sixfab/tinylab/README.md

# tinylab
[tinylab](https://sixfab.com/product/tinylab-exclusive-kit/) : prototype easier than ever
