sixfab/tinylab/case/tinylab_cap.STL

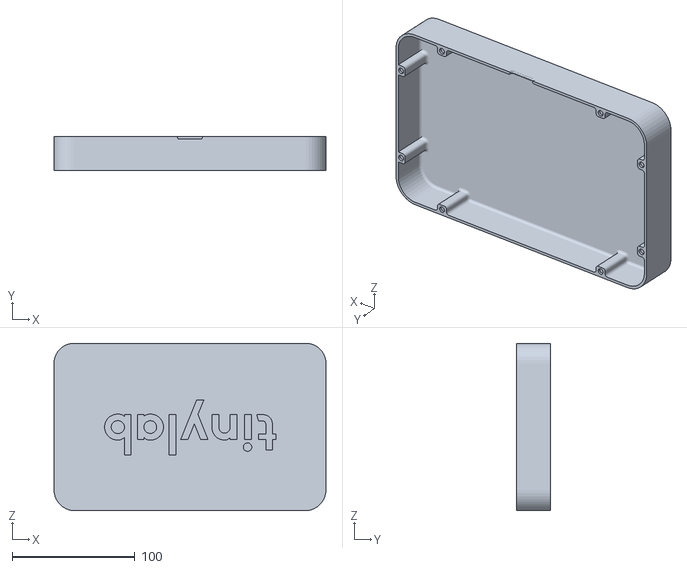
[picture p1: CAD file, 2016-04-21]
case/tinylab_cap.STL
221.3 x 27.5 x 136.2
