sixfab/tinylab/case/tinylab_bottom_plate.STL

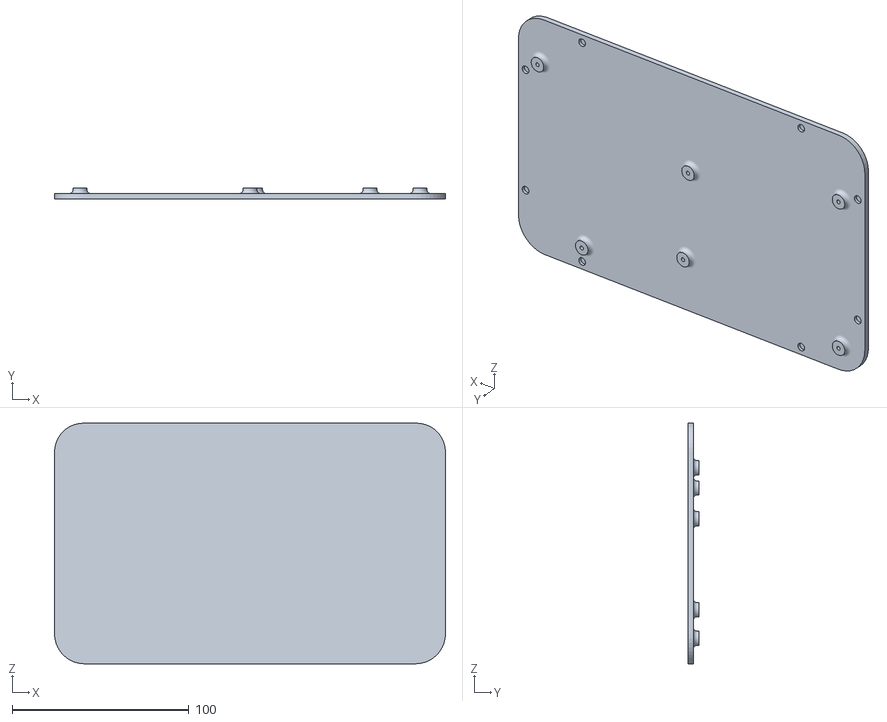
[picture p2: CAD file, 2016-04-21]
case/tinylab_bottom_plate.STL
221.3 x 6.00 x 136.2
