sixfab/tinylab/hardware/tinylab_09-03-16.brd

## EAGLE design hardware/tinylab_09-03-16.brd (2016-04-22)

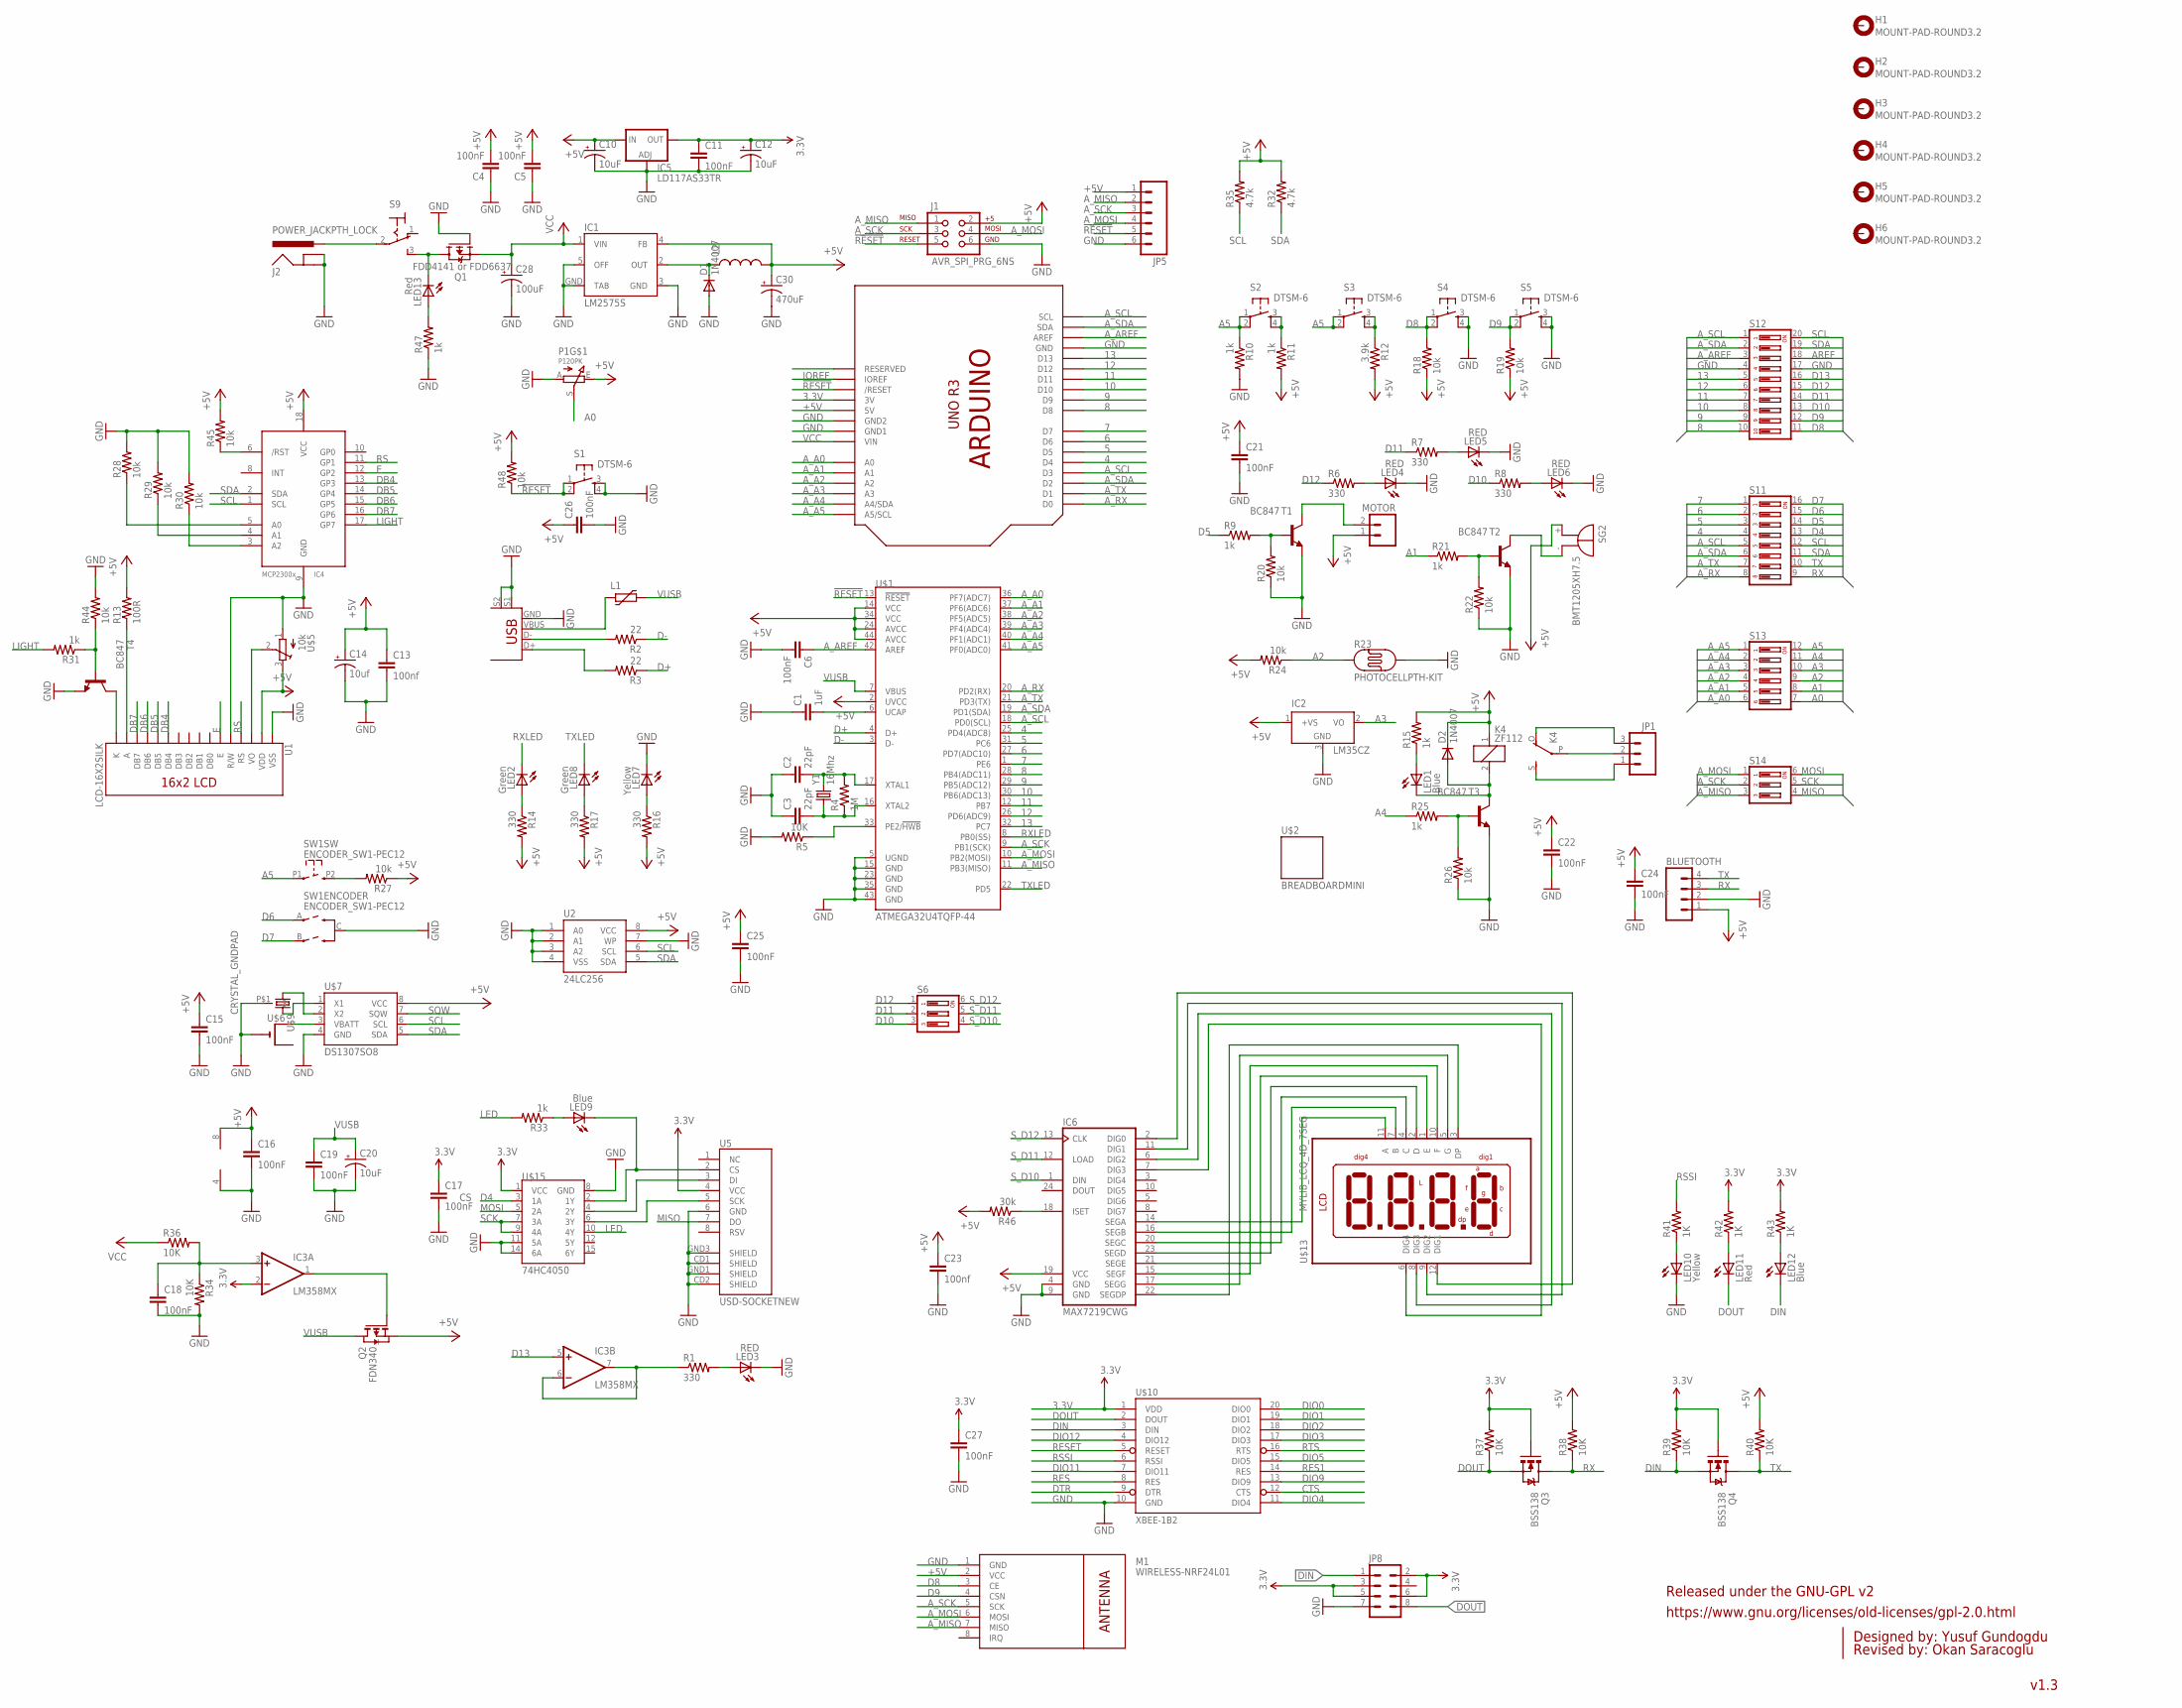
[picture p3: schematic tinylab_09-03-16.sch]

Parts:
BLUETOOTH: M04PTH; 1X04
C1: 1uF; 1206
C2, C3: 22pF; 0805
C4, C5, C6, C11, C15, C16, C17, C18, C19, C21, C22, C24, C25, C26, C27: 100nF; 0805
C10, C12, C20: 10uF; EIA3216
C13, C23: 100nf; 0805
C14: 10uf; EIA3216
C28: 100uF; NIPPON_F80
C30: 470uF; PANASONIC_G
D1, D2: 1N4007; SMA-DIODE_ALT
H1, H2, H3, H4, H5, H6: MOUNT-PAD-ROUND3.2; 3,2-PAD
IC1: LM2575S; TO263-5
IC2: LM35CZ; TO92
IC3: LM358MX; SO08
IC4: MCP2300X/SO; SO18W
IC5: LD117AS33TR; SOT223
IC6: MAX7219CWG; SO24W
J1: AVR_SPI_PRG_6NS; 2X3-NS
J2: POWER_JACKPTH_LOCK; POWER_JACK_PTH_LOCK
JP1: M03-SCREW-5MM; SCREWTERMINAL-5MM-3
JP5: M06SIP; 1X06
JP8: M04X2; 2X4
K4: ZF112
L1: FUSE_PTC-0805; PTC0805
L2: INDUCTORPWR; CDRH125
LED1, LED9, LED12: Blue; CHIPLED_0805
LED2, LED8: Green; CHIPLED_0805
LED3, LED4, LED5, LED6: RED; LED5MM
LED7, LED10: Yellow; CHIPLED_0805
LED11, LED13: Red; CHIPLED_0805
M1: WIRELESS-NRF24L01
MOTOR: M023.5MM; SCREWTERMINAL-3.5MM-2
P1: P120PK
Q1: FDD4141 or FDD6637; TO252
Q2: FDN340; SOT-23
Q3, Q4: BSS138; SOT23-3
R1, R6, R7, R8, R14, R16, R17: 330; 0805
R2, R3: 22; 0805
R4: 1M; 0805
R5, R34, R36, R37, R38, R39, R40: 10K; 0805
R9, R10, R11, R15, R21, R25, R31, R33, R47: 1k; 0805
R12: 3.9k; 0805
R13: 100R; 0805
R18, R19, R20, R22, R24, R26, R27, R28, R29, R30, R44, R45, R48: 10k; 0805
R23: PHOTOCELLPTH-KIT; PHOTOCELL-KIT
R32, R35: 4.7k; 0805
R41, R42, R43: 1K; 0805
R46: 30k; 0805
S1, S2, S3, S4, S5: DTSM-6
S6, S14: DIP03YL
S9: M9040P
S11: DIP08YL
S12: DIP10YL
S13: DIP06YL
SG2: BMT1205XH7.5
SW1: ENCODER_SW1-PEC12; PEC12_INCREMENTAL_ENCODER
T1, T2, T3, T4: BC847; SOT23-BEC
U1: LCD-16X2SILK; LCD-16X2
U2: 24LC256; SO08
U5: USD-SOCKETNEW; MICRO-SD-SOCKET-PP
U$1: ATMEGA32U4TQFP-44; TQFP44
U$2: BREADBOARDMINI; BREADBOARD-MINI
U$3: USB+SHIELD; USB-B-PTH
U$4: UNO_R3
U$5: 10k; TC33X
U$6: CR1220SMT; CR1220-SMD
U$7: DS1307SO8; SO08
U$9: CRYSTAL_GNDPAD; TC38H_GNDPAD
U$10: XBEE-1B2; XBEE-SILK
U$13: MYLIB_LCQ_4D_7SEG; MYLIB_LDQ_4D_7SEG
U$15: 74HC4050; SO016
Y1: 16Mhz; CRYSTAL-SMD-5X3

Connections:
3.3V: C11.1, C12.A (+), C17.1, C27.1, IC3.2 (-IN), IC5.4 (OUT), JP8.2, JP8.3, JP8.5, JP8.6, Q3.1 (G), Q4.1 (G), R37.2, R39.2, R42.2, R43.2, U5.4 (VCC), U$4.3V, U$10.1 (VDD), U$15.1 (VCC)
4: S11.4, U$1.25 (PD4(ADC8)), U$4.D4
5: S11.3, U$1.31 (PC6), U$4.D5
6: S11.2, U$1.27 (PD7(ADC10)), U$4.D6
7: S11.1, U$1.1 (PE6), U$4.D7
8: S12.10, U$1.28 (PB4(ADC11)), U$4.D8
9: S12.9, U$1.29 (PB5(ADC12)), U$4.D9
10: S12.8, U$1.30 (PB6(ADC13)), U$4.D10
11: S12.7, U$1.12 (PB7), U$4.D11
12: S12.6, U$1.26 (PD6(ADC9)), U$4.D12
13: S12.5, U$1.32 (PC7), U$4.D13
!RESET: J1.5, JP5.5, R48.1, S1.1, S1.2, U$1.13 (!RESET), U$4.RESET (/RESET)
+5V: BLUETOOTH.1, C4.2, C5.2, C10.A (+), C13.1, C14.A (+), C15.1, C16.1, C21.1, C22.1, C23.1, C24.1, C25.1, C26.1, C30.+, D2.C, IC1.4 (FB), IC2.1 (+VS), IC3.8 (V+), IC4.18 (VCC), IC5.3 (IN), IC6.19 (VCC), J1.2, JP5.1, K4.1, L2.2, M1.2 (VCC), MOTOR.1, P1.E, Q2.2 (S), R11.2, R12.2, R13.2, R14.2, R15.2, R16.2, R17.2, R18.1, R19.1, R24.2, R27.1, R32.2, R35.2, R38.2, R40.2, R45.2, R46.2, R48.2, SG2.+, U1.2 (VDD), U2.8 (VCC), U$1.2 (UVCC), U$1.14 (VCC), U$1.24 (AVCC), U$1.34 (VCC), U$1.44 (AVCC), U$4.5V, U$5.3 (E), U$7.8 (VCC)
A0: P1.S, S13.7
A1: R21.1, S13.8
A2: R23.1, R24.1, S13.9
A3: IC2.2 (VO), S13.10
A4: R25.1, S13.11
A5: R10.1, S2.1, S2.2, S3.1, S3.2, S13.12, SW1.P1 (1)
AREF: S12.18
A_A0: S13.6, U$1.36 (PF7(ADC7)), U$4.A0
A_A1: S13.5, U$1.37 (PF6(ADC6)), U$4.A1
A_A2: S13.4, U$1.38 (PF5(ADC5)), U$4.A2
A_A3: S13.3, U$1.39 (PF4(ADC4)), U$4.A3
A_A4: S13.2, U$1.40 (PF1(ADC1)), U$4.A4 (A4/SDA)
A_A5: S13.1, U$1.41 (PF0(ADC0)), U$4.A5 (A5/SCL)
A_AREF: C6.1, S12.3, U$1.42 (AREF), U$4.AREF
A_MISO: J1.1, JP5.2, M1.7 (MISO), S14.3, U$1.11 (PB3(MISO))
A_MOSI: J1.4, JP5.4, M1.6 (MOSI), S14.1, U$1.10 (PB2(MOSI))
A_RX: S11.8, U$1.20 (PD2(RX)), U$4.D0
A_SCK: J1.3, JP5.3, M1.5 (SCK), S14.2, U$1.9 (PB1(SCK))
A_SCL: S11.5, S12.1, U$1.18 (PD0(SCL)), U$4.D3, U$4.SCL
A_SDA: S11.6, S12.2, U$1.19 (PD1(SDA)), U$4.D2, U$4.SDA
A_TX: S11.7, U$1.21 (PD3(TX)), U$4.D1
CTS: U$10.12 (CTS)
D4: S11.13, U$15.3 (1A)
D5: R9.1, S11.14
D6: S11.15, SW1.A
D7: S11.16, SW1.B
D8: M1.3 (CE), R18.2, S4.1, S4.2, S12.11
D9: M1.4 (CSN), R19.2, S5.1, S5.2, S12.12
D10: R8.1, S6.3, S12.13
D11: R7.1, S6.2, S12.14
D12: R6.1, S6.1, S12.15
D13: IC3.5 (+IN), S12.16
D+: R3.1, U$1.4 (D+)
D-: R2.1, U$1.3 (D-)
DB4: IC4.13 (GP3), U1.11 (DB4)
DB5: IC4.14 (GP4), U1.12 (DB5)
DB6: IC4.15 (GP5), U1.13 (DB6)
DB7: IC4.16 (GP6), U1.14 (DB7)
DIN: JP8.1, LED12.C, Q4.2 (S), R39.1, U$10.3 (DIN)
DIO0: U$10.20 (DIO0)
DIO1: U$10.19 (DIO1)
DIO2: U$10.18 (DIO2)
DIO3: U$10.17 (DIO3)
DIO4: U$10.11 (DIO4)
DIO5: U$10.15 (DIO5)
DIO9: U$10.13 (DIO9)
DIO11: U$10.7 (DIO11)
DIO12: U$10.4 (DIO12)
DOUT: JP8.8, LED11.C, Q3.2 (S), R37.1, U$10.2 (DOUT)
DTR: U$10.9 (DTR)
E: IC4.12 (GP2), U1.6 (E)
GND: BLUETOOTH.2, C1.1, C2.1, C3.1, C4.1, C5.1, C6.2, C10.C (-), C11.2, C12.C (-), C13.2, C14.C (-), C15.2, C16.2, C17.2, C18.2, C19.2, C20.C (-), C21.2, C22.2, C23.2, C24.2, C25.2, C26.2, C27.2, C28.-, C30.-, D1.A, IC1.3 (GND), IC1.5 (OFF), IC1.GND (TAB), IC2.3 (GND), IC3.4 (V-), IC4.9 (GND), IC5.1 (ADJ), IC6.4 (GND), IC6.9 (GND), J1.6, J2.GND, J2.GNDBREAK, JP5.6, JP8.7, LED3.K (C), LED4.K (C), LED5.K (C), LED6.K (C), LED7.C, LED10.C, M1.1 (GND), P1.A, Q1.1 (G), R5.2, R10.2, R20.1, R22.1, R23.2, R26.1, R28.2, R29.2, R30.2, R34.2, R44.2, R47.1, S1.3, S1.4, S4.3, S4.4, S5.3, S5.4, S12.4, S12.17, SW1.C, T1.E, T2.E, T3.E, T4.E, U1.1 (VSS), U1.5 (R/W), U2.1 (A0), U2.2 (A1), U2.3 (A2), U2.4 (VSS), U2.7 (WP), U5.6 (GND), U5.CD1 (SHIELD), U5.CD2 (SHIELD), U5.GND1 (SHIELD), U5.GND3 (SHIELD), U$1.5 (UGND), U$1.15 (GND), U$1.23 (GND), U$1.35 (GND), U$1.43 (GND), U$3.GND, U$3.S1, U$3.S2, U$4.GND, U$4.GND1, U$4.GND2, U$5.1 (A), U$6.-, U$7.4 (GND), U$9.P$1 (3), U$10.10 (GND), U$15.8 (GND), U$15.11 (5A), U$15.14 (6A)
IOREF: U$4.IOREF
LED: R33.2, U$15.10 (4Y)
LIGHT: IC4.17 (GP7), R31.2
MISO: S14.4, U5.7 (DO)
MOSI: S14.6, U$15.5 (2A)
unnamed: R2.2, U$3.D-
unnamed: R3.2, U$3.D+
unnamed: LED3.A, R1.2
unnamed: C1.2, U$1.6 (UCAP)
unnamed: R11.1, S2.3, S2.4
unnamed: C3.2, R4.1, U$1.16 (XTAL2), Y1.1
unnamed: C2.2, R4.2, U$1.17 (XTAL1), Y1.3 (2)
unnamed: R21.2, R22.2, T2.B
unnamed: R5.1, U$1.33 (PE2/!HWB)
unnamed: D1.C, IC1.2 (OUT), L2.1
unnamed: R12.1, S3.3, S3.4
unnamed: R9.2, R20.2, T1.B
unnamed: LED4.A, R6.2
unnamed: JP1.3, K4.O
unnamed: LED5.A, R7.2
unnamed: MOTOR.2, T1.C
unnamed: LED6.A, R8.2
unnamed: SG2.-, T2.C
unnamed: LED1.A, R15.1
unnamed: R25.2, R26.2, T3.B
unnamed: D2.A, K4.2, LED1.C, T3.C
unnamed: LED2.A, R14.1
unnamed: LED8.A, R17.1
unnamed: JP1.2, K4.P
unnamed: JP1.1, K4.S
unnamed: J2.PWR, S9.2
unnamed: LED13.C, Q1.3 (D), S9.3 (S)
unnamed: IC4.5 (A0), R28.1
unnamed: IC4.4 (A1), R29.1
unnamed: IC4.3 (A2), R30.1
unnamed: R27.2, SW1.P2 (2)
unnamed: R31.1, R44.1, T4.B
unnamed: U1.3 (VO), U$5.2 (S)
unnamed: T4.C, U1.16 (K)
unnamed: U$7.2 (X2), U$9.1
unnamed: U$6.+$1 (+), U$7.3 (VBATT)
unnamed: IC6.14 (SEGA), U$13.11 (A)
unnamed: U5.3 (DI), U$15.4 (2Y)
unnamed: U5.5 (SCK), U$15.6 (3Y)
unnamed: U$7.1 (X1), U$9.2
unnamed: LED9.A, R33.1
unnamed: LED9.C, U5.2 (CS), U$15.2 (1Y)
unnamed: L1.1, U$3.VBUS
unnamed: C18.1, IC3.3 (+IN), R34.1, R36.2
unnamed: LED10.A, R41.1
unnamed: IC3.1 (OUT), Q2.3 (G)
unnamed: IC3.6 (-IN), IC3.7 (OUT), R1.1
unnamed: LED11.A, R42.1
unnamed: LED12.A, R43.1
unnamed: LED13.A, R47.2
unnamed: IC4.6 (/RST), R45.1
unnamed: IC6.18 (ISET), R46.1
unnamed: IC6.16 (SEGB), U$13.7 (B)
unnamed: IC6.20 (SEGC), U$13.4 (C)
unnamed: IC6.23 (SEGD), U$13.2 (D)
unnamed: IC6.21 (SEGE), U$13.1 (E)
unnamed: IC6.15 (SEGF), U$13.10 (F)
unnamed: IC6.17 (SEGG), U$13.5 (G)
unnamed: IC6.22 (SEGDP), U$13.3 (DP)
unnamed: IC6.7 (DIG3), U$13.6 (DIG4)
unnamed: IC6.6 (DIG2), U$13.8 (DIG3)
unnamed: IC6.11 (DIG1), U$13.9 (DIG2)
unnamed: IC6.2 (DIG0), U$13.12 (DIG1)
unnamed: R13.1, U1.15 (A)
unnamed: LED7.A, R16.1
RES: U$10.8 (RES)
RES1: U$10.14 (RES)
RESET: U$10.5 (RESET)
RS: IC4.11 (GP1), U1.4 (RS)
RSSI: R41.2, U$10.6 (RSSI)
RTS: U$10.16 (RTS)
RX: BLUETOOTH.3, Q3.3 (D), R38.1, S11.9
RXLED: LED2.C, U$1.8 (PB0(SS))
SCK: S14.5, U$15.7 (3A), U$15.9 (4A)
SCL: IC4.1 (SCL), R35.1, S11.12, S12.20, U2.6 (SCL), U$7.6 (SCL)
SDA: IC4.2 (SDA), R32.1, S11.11, S12.19, U2.5 (SDA), U$7.5 (SDA)
SQW: U$7.7 (SQW)
S_D10: IC6.1 (DIN), S6.4
S_D11: IC6.12 (LOAD), S6.5
S_D12: IC6.13 (CLK), S6.6
TX: BLUETOOTH.4, Q4.3 (D), R40.1, S11.10
TXLED: LED8.C, U$1.22 (PD5)
VCC: C28.+, IC1.1 (VIN), Q1.2 (S), R36.1, U$4.VIN
VUSB: C19.1, C20.A (+), L1.2, Q2.1 (D), U$1.7 (VBUS)

Notes on the sheet:
Released under the GNU-GPL v2
https://www.gnu.org/licenses/old-licenses/gpl-2.0.html
Designed by: Yusuf Gundogdu
Revised by: Okan Saracoglu
v1.3

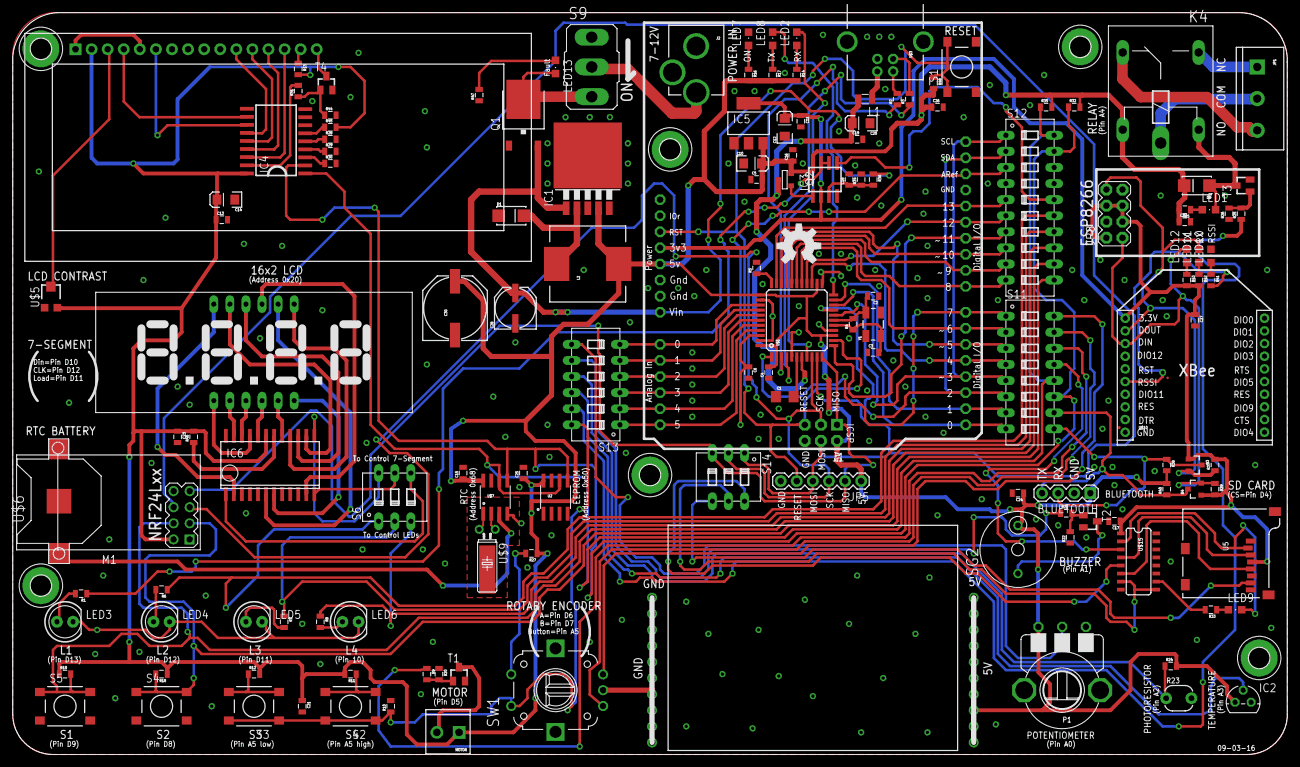
[picture p4: board tinylab_09-03-16.brd from above]

Board: 2 copper layers, 201.3 x 117.2 mm, 151 parts (0 on the bottom side), 136 nets.

Other parts of the board:
U$11: TINYLAB_LOGO_LARGE
U$14: OSHW-LOGO-L
