sixfab/tinylab/(threads)

Thread 6 (2017-08-11):

tinylab_test_code fails to compile

gmacario, 2017-08-11:
Tested with Arduino 1.8.2 (Windows 10) and the following libraries loaded by the Arduino Library Manager:

- DS1307RTC Version 1.4.0
- LedControl Version 1.0.6
- LiquidTWI2-master Version unknown (from https://github.com/lincomatic/LiquidTWI2)
- RF24 Version 1.3.0
- RotaryEncoder Version 1.1.0
- SdFat Version 1.0.3
- Time Version 1.5.0
- extEEPROM Version 3.3.5

```
Arduino: 1.8.2 (Windows 10), Board: "Arduino Leonardo"

In file included from D:\data\github\sixfab\tinylab\test_code\tinylab_test_code\tinylab_test_code.ino:30:0:

C:\Users\gmacario\Documents\Arduino\libraries\DS1307RTC/DS1307RTC.h:19:22: error: 'tmElements_t' has not been declared

     static bool read(tmElements_t &tm);

                      ^

C:\Users\gmacario\Documents\Arduino\libraries\DS1307RTC/DS1307RTC.h:20:23: error: 'tmElements_t' has not been declared

     static bool write(tmElements_t &tm);

                       ^

tinylab_test_code:41: error: 'tmElements_t' does not name a type

 tmElements_t tm;

 ^

D:\data\github\sixfab\tinylab\test_code\tinylab_test_code\tinylab_test_code.ino: In function 'void setup()':

tinylab_test_code:119: error: expected primary-expression before ')' token

     if (RTC.write(tm)) {

                     ^

D:\data\github\sixfab\tinylab\test_code\tinylab_test_code\tinylab_test_code.ino: In function 'void loop()':

tinylab_test_code:377: error: expected primary-expression before ')' token

       if(RTC.read(tm)){

                     ^

tinylab_test_code:380: error: expected primary-expression before '.' token

     lcd.print(tm.Hour);

                 ^

tinylab_test_code:382: error: expected primary-expression before '.' token

     lcd.print(tm.Minute);

                 ^

tinylab_test_code:384: error: expected primary-expression before '.' token

     lcd.print(tm.Second);

                 ^

tinylab_test_code:447: error: 'twiClock400kHz' was not declared in this scope

        uint8_t eepStatus = eep.begin(twiClock400kHz);

                                      ^

D:\data\github\sixfab\tinylab\test_code\tinylab_test_code\tinylab_test_code.ino: In function 'bool getTime(const char*)':

tinylab_test_code:664: error: expected unqualified-id before '.' token

   tm.Hour = Hour;

     ^

tinylab_test_code:665: error: expected unqualified-id before '.' token

   tm.Minute = Min;

     ^

tinylab_test_code:666: error: expected unqualified-id before '.' token

   tm.Second = Sec;

     ^

exit status 1
'tmElements_t' does not name a type

This report would have more information with
"Show verbose output during compilation"
option enabled in File -> Preferences.

```

Closed 2017-11-08.

Thread 8 (2017-10-20):

Serial1 was not declared

Smus, 2017-10-20:
Hi

im getting:
twitter:45: error: 'Serial1' was not declared in this scope
   Serial1.begin(115200);

any ideas?

selengalp, 2017-11-08:
Please check out your selected arduino board? If you selected any other board from arduino leonardo, you would probably get this compilation error.

sjkim04, 2018-05-13:
Um........ I think you don't need '1'.
And.... this is an advice.
In the Epalsite Electronics pdf, to begin serial, you need to type:
Serial.begin(9600)

Closed 2018-05-14.

Thread 9 (2022-11-01):

Tinylab - Software Serial

mugekuskon, 2022-11-01:
Hello,

I wanted to ask whether it is possible to use the SoftwareSerial library in tinylab? Most of the pins are occupied, so I couldn't managed to use the library. I hope you have an advice.

Müge

ozgurtzc, 2022-11-01:
Hi, @mugekuskon

There are dip switches on TinyLab. With these switches, you can connect to the components on the card. If you do not want to access any component and you want to make an output from the female connectors with the help of jumpers, you should control the dip switches. Because UART protocol is normally used on point-to-point link and does not define a "bus" as such. More than one output cannot use the same line.

Also, if you want to use UART in interrupt mode, you should pay attention to the pins you will use.

SoftwareSerial library has the following known limitations:

> It cannot transmit and receive data at the same time.

> If using multiple software serial ports, only one can receive data at a time.

> Not all pins support change interrupts, so only the following can be used for RX: 8, 9, 10, 11, 14 (MISO), 15 (SCK), 16 (MOSI).

mugekuskon, 2022-11-02:
Thanks for your immediate answer. Actually, I am not willing to use SoftwareSerial library as we can use Serial1 in Leonardo. My code is working well in the Arduino IDE; however when I try to install RIOT on Tinylab, and upload my code with "avrdude -c avr109 -p m32u4 -P /dev/tty.usbmodem14101  -U flash:w:/U...../bin/arduino-leonardo/tinylab_thingspeak.hex" command, it gives me an error such as "/arduino_sketches.cpp:72:4: error: 'Serial1' was not declared in this scope; did you mean 'Serial'?". In order to avoid this error, I included HardwareSerial.h in my code, and the error was gone. I personally don't think this is the correct action that I should've taken, since my code is not sending any data to Thingspeak now. (it used to send temperature, potentiometer etc. data when I ran that code in Arduino IDE).

To sum up, I wanted to ask you whether there is a file or anything else that I should include in my folder in order to tinylab acts the same when a code is uploaded with avrdude from terminal as it is in arduino IDE. (I tried all these operations in a Ubuntu VM in Windows 11, an Ubuntu machine and lastly in a MacBookAir 2013)

Thanks in advance,
Müge

ozgurtzc, 2022-11-05:
avrdude is a customized upload and download tool just for avr microcontrollers. avrdude allows you to read or write just by accessing your microcontroller's ROM or RAM. Therefore, it cannot interfere with the code.

It seems to me that the problem is with RIOT's source library. RIOT has already said here that they do not support all the arduino features. See [https://api.riot-os.org/group__sys__arduino.html](url)

Arduino Leonardo also uses Serial1 USB(CDC) Virtual COM port. When I examine RIOT's Wiki site, I see that it does not support USB(CDC) anyway. See [https://doc.riot-os.org/group__boards__arduino-leonardo.html](url)
