sixfab/tinylab/(commit log)

2016-01-11 added hardware design files
    [Arduino_lab_v1.2.brd.2.brd, Arduino_lab_v1.2.sch]
2016-01-11 added mechanical parts of case
    [D4L1.5_neodyum_magnet.SLDPRT, tinylab_bottom_plate.SLDPRT, tinylab_cap.SLDPRT, tinylab_case_assembly.SLDASM, tinylab_pcb_solid_sketch.SLDPRT]
2016-01-19 added hardware schematic files on pdf format
2016-04-05 case is made suitable for molding.
    [tinylab_bottom_plate.SLDPRT, tinylab_cap.SLDPRT, tinylab_case_assembly.SLDASM]
2016-04-11 added stl files
    [D4L1.5_neodyum_magnet.SLDPRT, tinylab_bottom_plate.SLDPRT, tinylab_bottom_plate.STL, tinylab_cap.SLDPRT, tinylab_cap.STL, tinylab_case_assembly.SLDASM, tinylab_pcb_solid_sketch.SLDPRT]
2016-04-21 added extra magnet mounts and resized montage holes
    [tinylab_bottom_plate.STL, tinylab_cap.STL]
2016-04-22 added resistor on lcd backlight led and done some little changes.
    [tinylab_09-03-16.brd, tinylab_09-03-16.sch]
2016-08-02 fulfilled the display bug on rtc test
    [tinylab_test_code.ino]
2016-08-16 Switch from SD library to SdFat library
    SD library is extremely large. SdFat library is much smaller and is fine for what this project does. Making this change lowers project size from 99% of maximum upload to 86% of maximum.
2017-03-16 Update basic_digital_watch.ino
    Fix "Add Header"
    [basic_digital_watch.ino]
2017-08-11 tinylab_test_code: Fix for extEEPROM 3.3.5
    The extEEPROM library available in tinylab/library is an old version where the enum twiClockFreq_t was defined globally.
    More recent versions of the extEEPROM library have moved the definition of clock frequency enumeration inside the class definition.
    See https://github.com/PaoloP74/extEEPROM/commit/1944b15231a1f71187e1cd163595b2b80981ab4c
    Prepend class namespace to fix the compilation issue.
    Tested with extEEPROM Library Version 3.3.5 (loaded by the Arduino Library Manager)
    Fix https://github.com/sixfab/tinylab/issues/6
    [tinylab_test_code.ino]
2017-08-11 tinylab_test_code: Include TimeLib.h
    Fix compilation error
    In file included from ...\tinylab_test_code\tinylab_test_code.ino:30:0:
    ....\Arduino\libraries\DS1307RTC/DS1307RTC.h:19:22: errror: 'tmElements_t' has not been declared
    static bool read(tmElements_t &tm);
    [tinylab_test_code.ino]
2017-11-08 updated ledControl library readme.md file
